CColetteO/physical-computing-final/images/IMG_3853.JPG

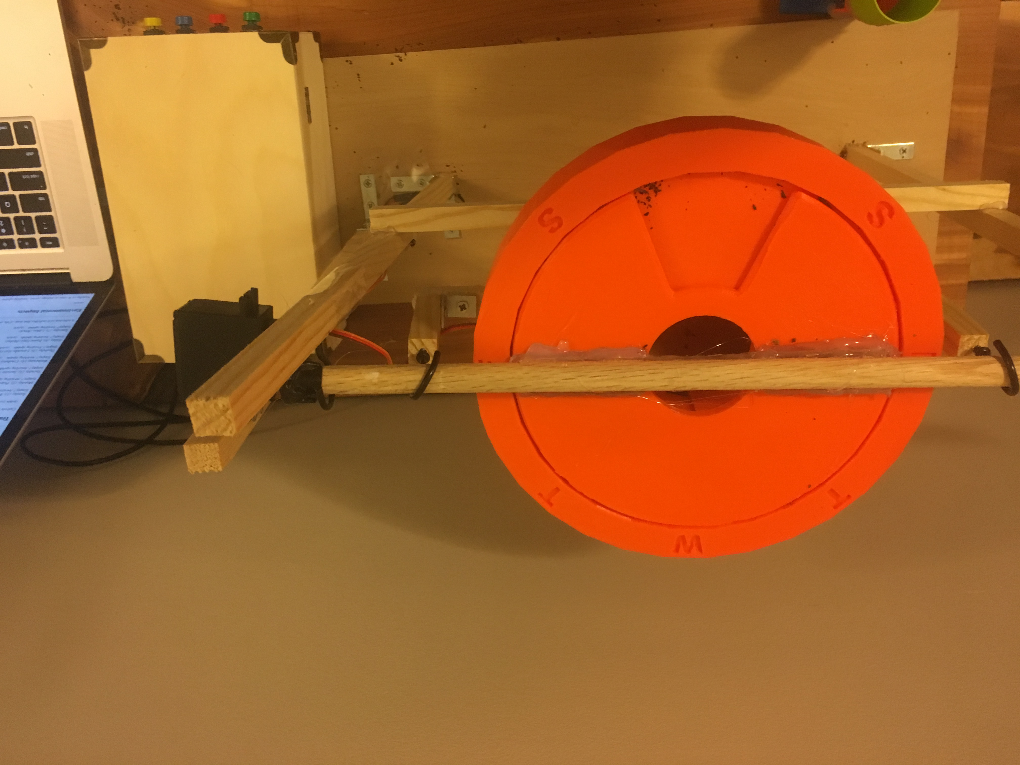
images/IMG_3853.JPG
